mejgan/esp32_ha_grow/case/preview/base_back.png

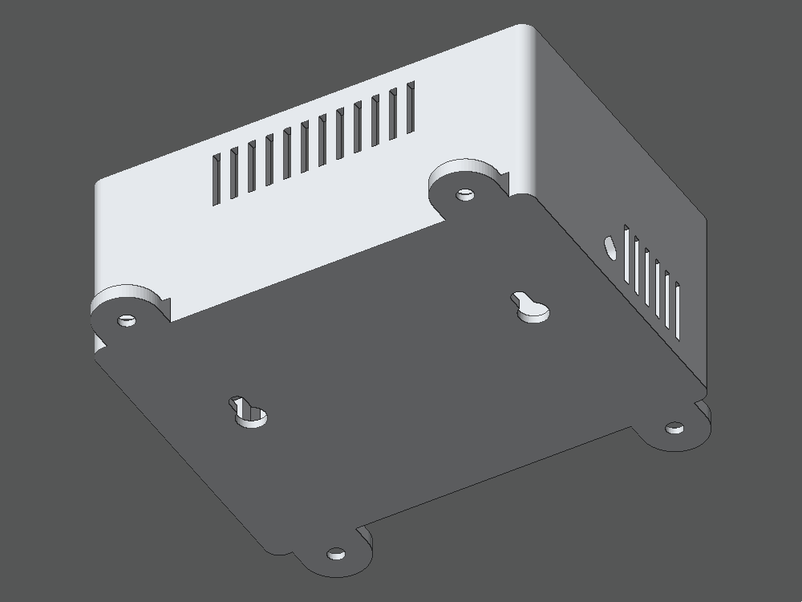
case/preview/base_back.png
