mejgan/esp32_ha_grow/case/preview/base_cables.png

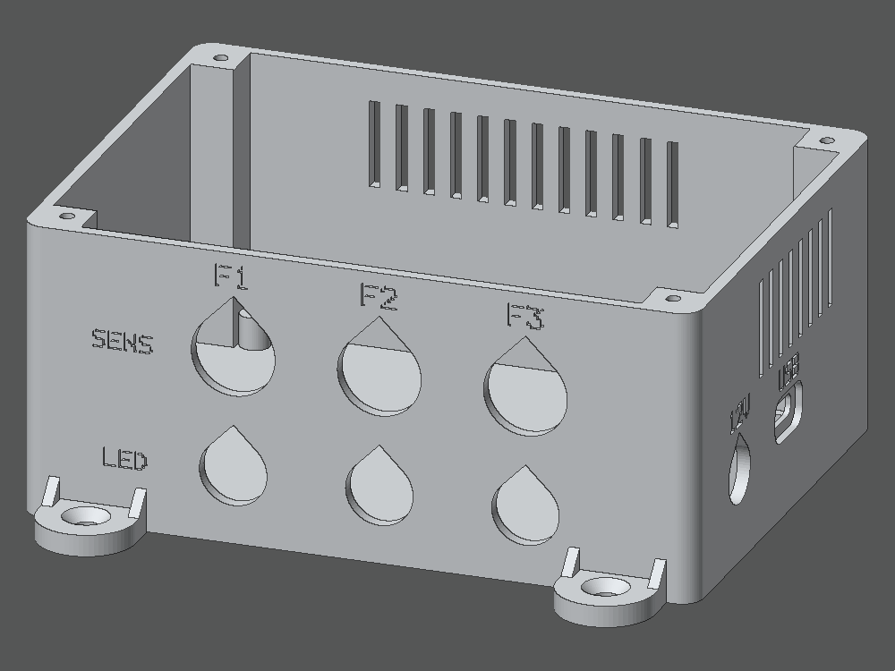
case/preview/base_cables.png
