mejgan/esp32_ha_grow/case/preview/base_ports.png

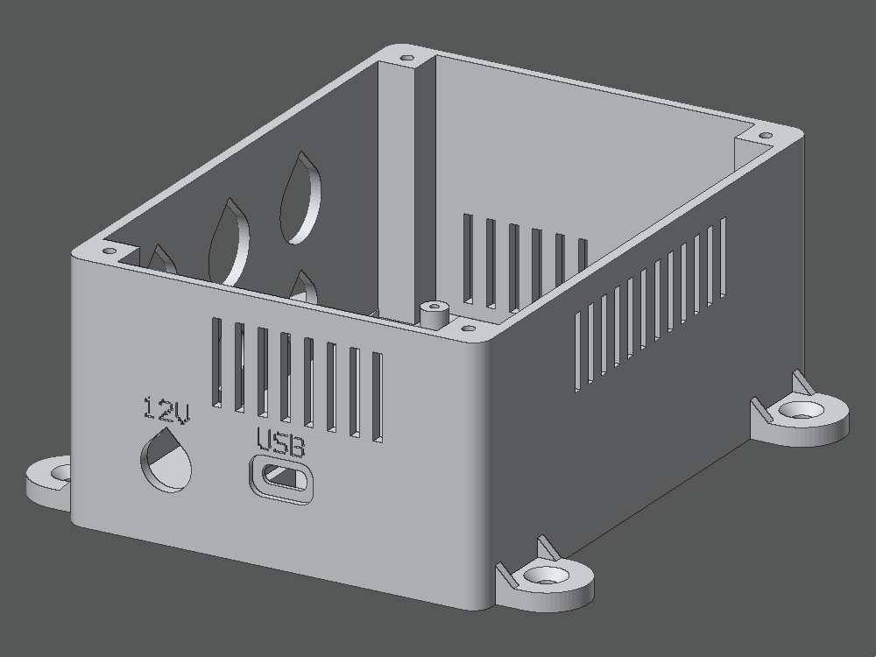
case/preview/base_ports.png
