mejgan/esp32_ha_grow/case/preview/lid_inside_lcd2004.png

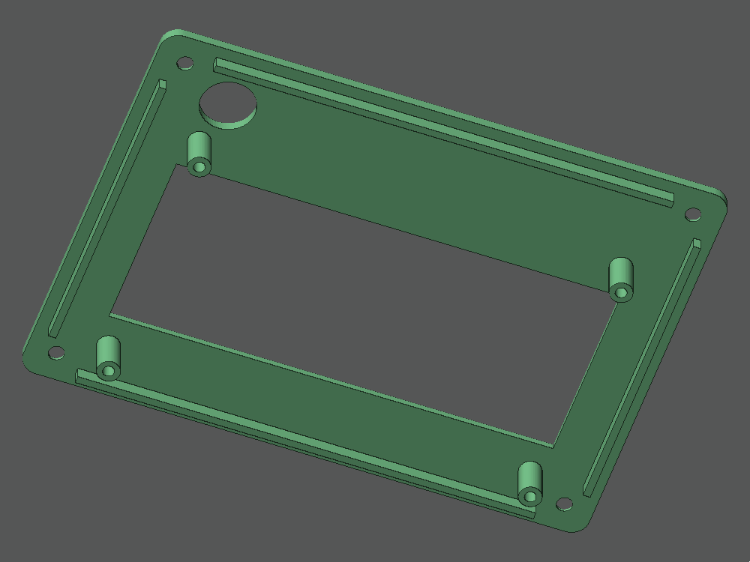
case/preview/lid_inside_lcd2004.png
