mejgan/esp32_ha_grow/case/stl/base.stl

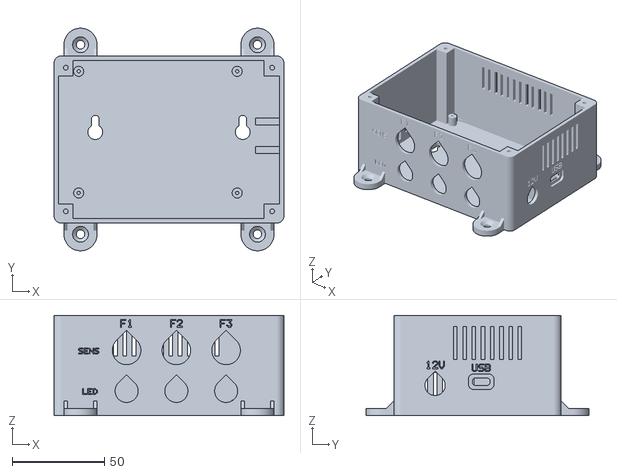
[picture p10: CAD file, 2026-11-03]
case/stl/base.stl
124.8 x 120.8 x 54.4
