mejgan/esp32_ha_grow/case/stl/lid_ili9341_28.stl

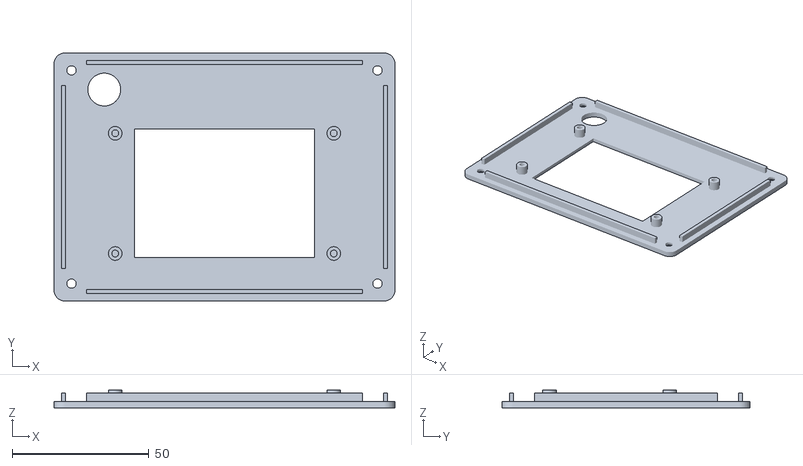
[picture p11: CAD file, 2026-11-03]
case/stl/lid_ili9341_28.stl
124.8 x 90.8 x 6.50
