mejgan/esp32_ha_grow/case/stl/lid_ssd1306_096.stl

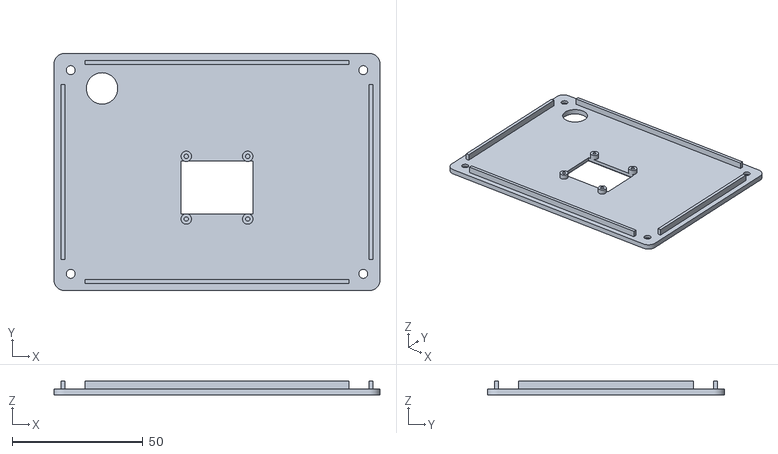
[picture p12: CAD file, 2026-11-03]
case/stl/lid_ssd1306_096.stl
124.8 x 90.8 x 5.40
