mejgan/esp32_ha_grow/case/stl/lid_lcd2004.stl

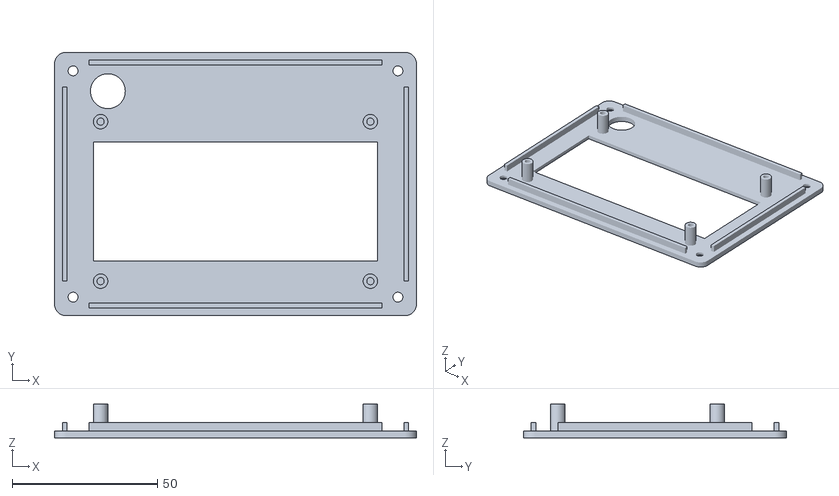
[picture p13: CAD file, 2026-11-03]
case/stl/lid_lcd2004.stl
124.8 x 90.8 x 11.7
