mejgan/esp32_ha_grow/case/stl/lid_sh1106_130.stl

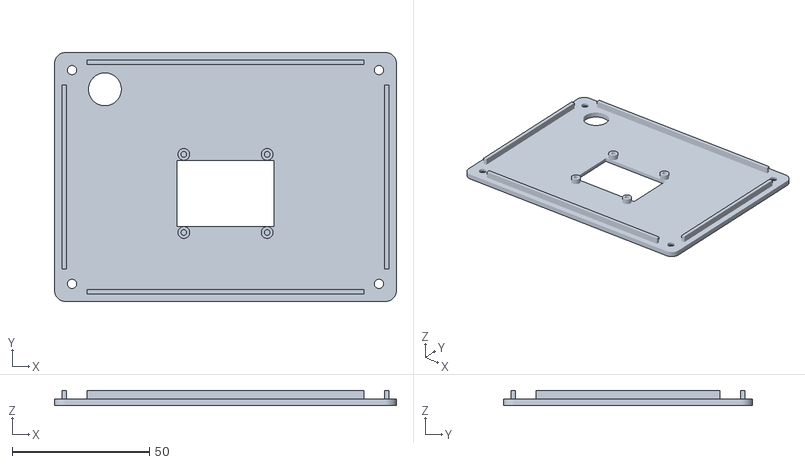
[picture p14: CAD file, 2026-11-03]
case/stl/lid_sh1106_130.stl
124.8 x 90.8 x 5.40
