mejgan/esp32_ha_grow/case/stl/lid_lcd1602.stl

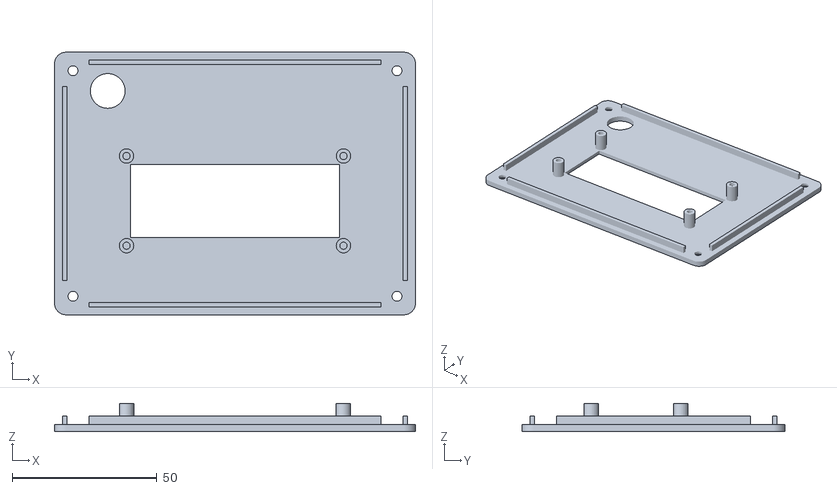
[picture p15: CAD file, 2026-11-03]
case/stl/lid_lcd1602.stl
124.8 x 90.8 x 9.70
