mejgan/esp32_ha_grow/(commit log)

2026-11-02 init commit
    [partitions.csv]
2026-11-03 Fix sensor timing and Zigbee state sync; add displays, OTA, tests
    Bug fixes:
    - Sensor waits rounded down at the 100 Hz tick (BMP180 temperature wait
    was 0 ms, pressure 20 ms, DHT11 start pulse could be 10 ms). Tick is
    now 1 kHz, waits round up, BMP180 polls its conversion-done bit and
    AHT10 polls its busy bit.
    - DHT11 is read with the RMT receiver instead of a 5 ms interrupts-off
    bit-bang that blocked the Zigbee radio.
    - Remote writes the firmware overrode (ON during heat lock, clamped
    values) left the ZCL attribute wrong and swallowed the next command.
    The echo cache now tracks what the attribute really holds, ON is
    refused while a floor is disabled or heat-locked, and out-of-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
    [partitions.csv]
2026-11-03 Add 3D-printable enclosure with a lid per display type
    case/growbox_case.py generates the box and lids (manifold3d) and can
    check the fit: simple models of the perfboard and parts, cable glands,
    DC jack, button and display module/glass must not intersect each other
    or the case. Box: 7x9 cm perfboard on standoffs, 6 labeled teardrop
    cable holes (PG7/GX12), USB-C opening at the DevKit, DC jack, vents,
    wall-mount keyholes, countersunk lid screws. Lids for no display,
    SSD1306 0.96"/0.91", SH1106 1.3", 16x2 and 20x4 LCD, ILI9341 2.8" and
    ST7789 1.3", each with window, standoffs or corner guides and a 12 mm
    button hole. STLs are in print orientation (no supports); previews and
    a CI job running the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
    [base.stl, lid_ili9341_28.stl, lid_lcd1602.stl, lid_lcd2004.stl, lid_none.stl, lid_sh1106_130.stl, lid_ssd1306_091.stl, lid_ssd1306_096.stl]
2026-11-03 Case: flush panel USB-C socket for flashing
    A USB-C breakout board slides into a cradle (rails, side guides, retaining
    lips) behind the right wall; the receptacle sits in a wall opening with a
    pocket outside so a cable plug goes in all the way. It is wired to the
    ESP32-C6's native USB (D+ GPIO13, D- GPIO12), so it flashes and logs
    without an extension cable, which would need room in front of the DevKit
    that the box doesn't have. The open slot to the DevKit's own ports is
    still available with USB_PORT = "open". 12V and USB labels on the right
    wall. The fit check now also models the breakout, its receptacle and a
    fully inserted plug (6.2 mm insertion).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
    [base.stl]
2026-11-03 Case: mounting ears with screw holes for the grow box wall
    Four ears flush with the back (two on the top edge, two on the bottom
    edge, near the corners) with countersunk holes for 4 mm wood screws and
    45-degree side ribs. They print flat on the bed with the base. The fit
    check now models the cable glands, cables and DC plug outside the box
    and a screwdriver over each ear hole, so a moved ear or gland that
    blocks a screw is reported. Keyholes stay as an alternative.
    Claude-Session: https://claude.ai/code/session_0171wwpLivNgwPCEvPnxZDdq
    [base.stl]
2026-11-03 Add optional room sensor, wiring guide and camera time-lapse guide
    Room sensor: a temperature/humidity sensor next to the controller,
    outside the grow box, exposed on its own Zigbee endpoint (4, "room" in
    the Zigbee2MQTT converter) like a plain Zigbee climate sensor and shown
    on the display. Supported: DHT22/AM2302, DHT11, SHT3x, SHT4x,
    HTU21D/SHT21/Si7021 and BME280 (adds pressure; a BMP280 gives no
    humidity). The DHT driver now handles instances (one RMT channel each)
    and DHT22 frames. Conversions and CRCs are host-tested against datasheet
    examples (Sensirion CRC, HTU21D values, Bosch BMP280 example). Each room
    sensor type is built in CI alongside one of the display variants. The
    case gets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
    [base.stl]
2026-11-03 Add Arducam Mega cameras with Wi-Fi photo upload and Zigbee end device mode
    With CONFIG_ZB_ZED the GrowBox joins as a Zigbee end device (64 min
    timeout, receiver always on), the role Espressif rates stable next to
    Wi-Fi on the single ESP32-C6 radio. Then up to three Arducam Mega SPI
    cameras (one per floor) take a photo every N minutes while the floor's
    light is on: Wi-Fi is switched on, the JPEG is streamed from the
    camera's frame buffer to the PC server in 4 KB chunks (HTTP or HTTPS
    with a bearer token), and Wi-Fi is switched off again. A take_photo
    switch per floor in Zigbee2MQTT triggers a photo at once.
    The SPI bus is now shared between a TFT and the cameras (spi_bus.c).
    Camera pins are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
    [base.stl]
2026-11-03 Add a step-by-step build guide and rewrite the README
    docs/GUIDE.md walks through the whole build in order: parts and tools,
    printing the case, installing ESP-IDF v6.0, building and flashing the
    bare DevKit, pairing with Zigbee2MQTT (including
    advanced.enable_external_js, which new installs set to false), the
    perfboard, power checks with a multimeter, sensor cables, mounting,
    the Home Assistant entities, soil calibration, the optional display,
    button, room sensor and cameras, Zigbee OTA updates and a
    troubleshooting table.
    docs/make_board_layout.py draws the suggested perfboard layout from the
    case generator's dimensions (docs/board_layout.png), and
    docs/display_pages.png shows the display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
2026-11-03 Make every floor's sensors configurable in menuconfig
    Each floor now has four sensor slots in Grow Box -> Floor N, each
    optional:
    - temperature / humidity: DHT11, DHT22, AHT10/AHT20, SHT3x, SHT4x,
    HTU21D/Si7021 or BME280;
    - pressure: BMP180 or BMP280 (also a backup temperature);
    - soil: capacitive or resistive, with an optional power GPIO and
    per-floor calibration;
    - light: TEMT6000 or BH1750.
    A floor's I2C sensors go on the main bus (pins now in Grow Box -> I2C
    buses) or the LP bus. The defaults are the old fixed layout, and
    main/sdkconfig.rename carries renamed options over from an old sdkconfig.
    All digital sensors share one driver (sensor_dev.c, replacing aht10.c,
    bmp180.c and the r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
    [analog.c, analog.h, camera.c, check_configs.py, dht.c, dht.h, disp_lcd.c, growbox_logic.c]
